Whaltze/SCARA/SCARA_UI/trajectory/patterns/爱心.png

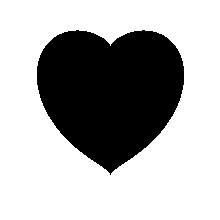
SCARA_UI/trajectory/patterns/爱心.png
