Whaltze/SCARA/(list of files, drawings)

Other design files:
PCB/Project Backups/新工程 [20260615, 14-53-20].pdsprj
PCB/Project Backups/新工程 [20260615, 15-15-52].pdsprj
PCB/Project Backups/新工程 [20260615, 15-15-53].pdsprj
PCB/Project Backups/新工程 [20260615, 15-25-33].pdsprj
PCB/Project Backups/新工程 [20260615, 15-25-38].pdsprj
PCB/Project Backups/新工程 [20260615, 15-33-31].pdsprj
PCB/Project Backups/新工程 [20260615, 16-06-37].pdsprj
PCB/Project Backups/新工程 [20260615, 16-11-07].pdsprj
PCB/Project Backups/新工程 [20260615, 16-44-57].pdsprj
PCB/Project Backups/新工程 [20260615, 17-07-40].pdsprj
PCB/新工程.pdsprj
