Whaltze/SCARA/SCARA_F103/UserApp/app_config.h

#ifndef APP_CONFIG_H
#define APP_CONFIG_H

/* 固件集中调参文件。
 * 机械尺寸、10kHz 控制周期、速度/加速度、串口缓冲、回零和 Flash 参数都优先在这里调整。
 * 修改后必须重新编译并重新烧录；同时确认 UI 里的 PPR、零点和机构尺寸保持一致。
 */

#include <stdint.h>

/* Firmware identity shown by VERSION. */
#define APP_FW_NAME "SCARA_F103"
#define APP_FW_VERSION "0.29.12-grbl-scara"

/* Current controller drives two stepper axes. */
#define APP_AXIS_COUNT 2u

/* Stepper driver ENA pins. Most optocoupled drivers enable when ENA is low. */
#define APP_STEPPER_ENA_ACTIVE_LEVEL 0u
#define APP_STEPPER_ENABLE_ON_BOOT 1u
/* Common-anode wiring: PUL+/DIR+/ENA+ to +5V, MCU drives PUL-/DIR-/ENA-.
 * The optocoupler is active when the MCU pin sinks low.
 */
#define APP_STEPPER_PUL_ACTIVE_LEVEL 0u
#define APP_STEPPER_M1_DIR_POSITIVE_LEVEL 1u
#define APP_STEPPER_M2_DIR_POSITIVE_LEVEL 0u
/* DM556 requires PUL high/low >= 2.5us and DIR setup >= 6us.
 * TIM1/TIM4 generate the pulse width in one-pulse mode. Only the uncommon
 * direction transition still uses the DWT setup delay.
 */
#define APP_STEPPER_PULSE_HIGH_US 3u
#define APP_STEPPER_PULSE_LOW_US 3u
#define APP_STEPPER_DIR_SETUP_US 6u

/* PWM 脉冲定时器基准频率，当前 1MHz 表示 1us 计数精度。 */
#define APP_STEPPER_TIMER_HZ 1000000u
/* 实时插补/速度更新频率。10000Hz 表示每 100us 执行一次运动内核。 */
#define APP_CONTROL_HZ 10000u
#define APP_CONTROL_PERIOD_US (1000000u / APP_CONTROL_HZ)
#define APP_STEPPER_ISR_DELAY_BUDGET_US (APP_CONTROL_PERIOD_US / 2u)
#define APP_STEPPER_WORST_BLOCKING_DELAY_US \
    (APP_AXIS_COUNT * APP_STEPPER_DIR_SETUP_US)

#if APP_STEPPER_WORST_BLOCKING_DELAY_US > APP_STEPPER_ISR_DELAY_BUDGET_US
#error "Configured step pulse delays exceed half of the control ISR period"
#endif

/* Laser PWM is generated by TIM3_CH2 at 1 kHz with 0.1% duty resolution.
 * ACTIVE_HIGH=1 matches the verified laser behavior: low/off, high/on.
 * Do not change the polarity while the laser is powered. Verify it with the
 * laser power disconnected and measure PA7 relative to the laser power GND.
 */
#define APP_LASER_PWM_HZ 1000u
#define APP_LASER_PWM_PERIOD_COUNTS 1000u
#define APP_LASER_COMMISSIONED 1u
#define APP_LASER_PWM_ACTIVE_HIGH 1u
#if APP_LASER_PWM_ACTIVE_HIGH
#define APP_LASER_PWM_OFF_COMPARE 0u
#else
#define APP_LASER_PWM_OFF_COMPARE APP_LASER_PWM_PERIOD_COUNTS
#endif
#define APP_LASER_POWER_DEFAULT_PERMILLE 10u
#define APP_LASER_POWER_MIN_PERMILLE 1u
#define APP_LASER_POWER_MAX_PERMILLE 50u
#define APP_LASER_BOOT_LOCKOUT_MS 1000u
#define APP_LASER_RELAY_READY_MS 100u
#define APP_LASER_IDLE_DISARM_MS 250u
#define APP_LASER_ARM_TIMEOUT_MS 5000u

/* 继电器逻辑电平：1=高电平有效(IN 高=吸合/激光通电)，0=低电平有效(IN 低=吸合)。
 * 默认 1，与当前硬件(高电平有效模块)一致。
 * 【安全】fail-safe 要求"释放电平=激光断电"：固件在上电/复位/故障/空闲一律把继电器驱动到
 * 释放电平，且激光头务必接在继电器的 COM/NO(常开)——释放时 NO 断开=断电。切勿用 NC(常闭)。
 * 若更换为低电平有效的继电器板，必须把本值改为 0，并在"激光断电"下用万用表确认上电/复位
 * 瞬间 NO 为断开；同时注意 CubeMX 生成的 gpio.c 初始电平也需对应(见 Control.md 激光清单)。 */
#define APP_LASER_RELAY_ACTIVE_LEVEL 1u
/* 落笔前继电器预合(吃掉机械合闸延时)的默认时长 ms；M6 不带 P 参数时用此值。
 * 需 >= 继电器实际机械动作时间，默认复用 APP_LASER_RELAY_READY_MS。 */
#define APP_LASER_RELAY_PREP_MS APP_LASER_RELAY_READY_MS

/* 最低有效 PPS，低于该值按停止处理，防止很慢的抖动脉冲。 */
#define APP_MIN_EFFECTIVE_PPS 16
#define APP_INTERPOLATOR_MIN_PPS 1
/* Default single-axis speed limit. 6400 PPR requires more PPS at the same mm/s. */
#define APP_MAX_PPS_DEFAULT 10000
/* 单轴 PPS 硬上限，只用于保护，实际运行应留足余量。 */
#define APP_MAX_PPS_HARD 50000

/* 默认加速度，单位 pulses/s^2；调大响应快但更容易振动/丢步。 */
#define APP_ACCEL_DEFAULT 200



/* 加速度上限，防止上位机或命令传入过激参数。 */
#define APP_ACCEL_MAX 5000

/* Software pulse position range. Only used when MCU-side limits are enabled. */
#define APP_MOTOR_MIN_POS (-2000000000L)
#define APP_MOTOR_MAX_POS (2000000000L)
/* 1: host PC owns workspace/path limit checks.
 * 0: MCU also enforces motor pulse range / joint range checks.
 */
#define APP_HOST_OWNS_LIMIT_CHECKS 1u

/* 电机和传动参数，用于脉冲与关节角换算；必须和上位机、驱动器拨码一致。 */
/* Driver pulses per revolution. Keep firmware, UI and physical DIP switches at 6400. */
#define APP_PULSES_PER_REV_M1 6400L
#define APP_PULSES_PER_REV_M2 6400L
/* Gear reduction ratio from motor shaft to active arm. */
#define APP_REDUCER_RATIO_M1 1L
#define APP_REDUCER_RATIO_M2 1L
/* Positive/negative sign for each motor direction. Use 1 or -1. */
#define APP_MOTOR1_DIR_SIGN 1L
#define APP_MOTOR2_DIR_SIGN 1L
/* Joint zero offsets in mrad after homing / mechanical calibration. */
#define APP_MOTOR1_ZERO_MRAD 2251L
#define APP_MOTOR2_ZERO_MRAD 890L

/* 反向间隙补偿（open-loop backlash compensation），单位：电机脉冲。
 * 每次电机换向时先多发这么多脉冲吃掉关节/联轴器旷量，再走正常轨迹；
 * 补偿不改动运动学位置(position_pulse)，只多发脉冲给驱动器。
 * 默认 0 = 未标定不补偿（行为与改动前一致）。现场用 $160/$161 在线标定，
 * 也可改这里的默认值。换算：pulses ≈ 旷量角(deg) × PPR / 360（PPR=6400 → 每脉冲≈0.056°）。
 * 只能补偿电机侧旷量；被动臂远端关节旷量需机械处理。
 */
#define APP_BACKLASH_PULSES_M1 0L
#define APP_BACKLASH_PULSES_M2 0L
/* 补偿脉冲发送速率（吃旷量为空载，定速无斜坡即可）。建议整除 APP_CONTROL_HZ。
 * 若标定时补偿段异响/丢步，调低此值。 */
#define APP_BACKLASH_COMP_PPS 2000
/* 补偿量上限保护，防止误设过大导致换向长时间空走。 */
#define APP_BACKLASH_MAX_PULSES 400L

/* SCARA geometry in micrometers.
 * Must match the upper computer kinematic model.
 */
/* Distance between the two base motor axes. */
#define APP_SCARA_BASE_UM 150000L
/* Left and right active arm lengths. */
#define APP_SCARA_ACTIVE1_UM 160000L
#define APP_SCARA_ACTIVE2_UM 160000L
/* Left and right passive arm lengths. */
#define APP_SCARA_PASSIVE1_UM 200000L
#define APP_SCARA_PASSIVE2_UM 200000L
/* Joint angle soft ranges in milliradians. */
#define APP_SCARA_THETA1_MIN_MRAD (-3142L)
#define APP_SCARA_THETA1_MAX_MRAD 3142L
#define APP_SCARA_THETA2_MIN_MRAD 0L
#define APP_SCARA_THETA2_MAX_MRAD 6283L
/* Elbow branch selection for inverse kinematics. Usually keep paired with UI. */
#define APP_SCARA_IK_LEFT_ELBOW_SIGN 1
#define APP_SCARA_IK_RIGHT_ELBOW_SIGN (-1)

/* Communication watchdog default.
 * 0 disables watchdog on boot; can be enabled later by command.
 */
#define APP_COMM_WATCHDOG_DEFAULT_MS 0u

/* Serial buffers and protocol sizing. */
/* Raw UART RX DMA ring buffer size in bytes. */
#define APP_SERIAL_RX_DMA_SIZE 256u
/* Grbl-style parsed-byte ring used by character-counting host streaming. */
#define APP_SERIAL_RX_RING_SIZE 256u
/* Max accepted single ASCII command line length. */
#define APP_SERIAL_LINE_SIZE 96u
/* TX staging buffer size for one formatted response. */
#define APP_SERIAL_TX_SIZE 512u
/* Realtime characters bypass the normal line queue. */
#define APP_SERIAL_REALTIME_QUEUE_DEPTH 8u
/* Number of pending TX messages that can wait in queue. */
#define APP_SERIAL_TX_QUEUE_DEPTH 8u
/* UART baudrate. Must match the upper computer. */
#define APP_SERIAL_BAUDRATE 115200u

/* Homing switch and homing process parameters. */
/* 0 means switch active-low, 1 means active-high. */
#define APP_HOME_SWITCH_ACTIVE_LEVEL 0u
/* Search direction for each homing axis. Use 1 or -1. 
// 左侧红色主动臂 Axis1：从 90° 竖直回零时应向左找水平限位，即角度增大到 180°。
*/

// 建议增加一个回零专用加速度，例如：
#define APP_HOME_ACCEL_PPS_S 3000

#define APP_HOME_AXIS1_DIR (1)
// 右侧蓝色主动臂 Axis2：若 HOME2 安装在右水平位置，则从 90° 竖直向右找 0°，角度减小。
#define APP_HOME_AXIS2_DIR (-1)
/* Homing search speed in pulses per second. */
#define APP_HOME_SEARCH_PPS 200
/* Pull-off distance after switch trigger, in pulses. */
#define APP_HOME_BACKOFF_PULSE 200L
/* Debounce time that the switch must stay active. */
#define APP_HOME_DEBOUNCE_MS 20u
/* Maximum allowed homing duration before timeout.   超时 时间*/
#define APP_HOME_TIMEOUT_MS 300000u
/* Joint angle references used by homing, in milliradians. 
两个臂的回零 轴1向着左边，轴2向着右边
左红臂水平回零点：向左水平 = 180° ≈ 3142 mrad。

mrad = deg × π / 180 × 1000
*/
// HORIZONTAL_MRAD：理论水平角度，仅用于仿真或参考
// SWITCH_MRAD：真实开关触发角度，用于实机回零标定
// VERTICAL_MRAD：回零后要回到的 90° 位置
#define APP_HOME_AXIS1_SWITCH_MRAD 3316L    /* 示例：左臂触发点约 190° */
#define APP_HOME_AXIS2_SWITCH_MRAD (-175L)   /* 示例：右臂触发点约 -5° */

#define APP_HOME_AXIS1_HORIZONTAL_MRAD 3142L
#define APP_HOME_AXIS2_HORIZONTAL_MRAD 0L
#define APP_HOME_AXIS1_VERTICAL_MRAD 1571L
#define APP_HOME_AXIS2_VERTICAL_MRAD 1571L

/* G-code stream planner parameters. */
/* Number of queued motion blocks kept by MCU. */
#define APP_GCODE_PLANNER_BLOCKS 48u
/* Timed DDA segments prefetched below the planner for queue-to-queue handoff. */
#define APP_STEPPER_TIMED_SEGMENTS 16u
#define APP_GRBL_SEGMENT_MS 5u
#define APP_GRBL_ACCEL_MM_S2 100.0f
#define APP_GRBL_MAX_ACCEL_MM_S2 1000.0f
#define APP_GRBL_JUNCTION_DEVIATION_MM 0.02f
#define APP_GRBL_ARC_TOLERANCE_MM 0.05f
#define APP_GRBL_MAX_FEED_MM_MIN 6000.0f
#define APP_GRBL_RAPID_MM_MIN 3000.0f
/* Wait time for the first block so a second block can arrive for blending. */
#define APP_GCODE_BLEND_MIN_BLOCKS 12u
#define APP_GCODE_BLEND_START_DELAY_MS 40u
/* Keep the final unknown-successor block in the planner while enough step
 * segments remain queued. This gives streamed short blocks time to arrive and
 * preserves their junction context instead of repeatedly planning from rest. */
#define APP_GCODE_TAIL_HOLDBACK_SEGMENTS 8u
/* Automatic status push period while streaming. */
#define APP_GCODE_STATUS_PERIOD_MS 200u
/* Default feed rate for G1 if host does not send F, in mm/min. */
#define APP_GCODE_DEFAULT_FEED_MM_MIN 300L
/* Retained persisted parameter for existing flash layouts. */
#define APP_MOVL_SEGMENT_UM 2000L

/* When a move settles (planner empty, stepper idle), the parser position is
 * re-anchored to the stepped pulses only if it diverges from the commanded
 * endpoint by more than this many pulses. Cleanly completed moves match exactly
 * (divergence 0) and keep their commanded coordinate; interrupted/fault-stopped
 * moves are re-anchored to the true stopped position. */
#define APP_POSITION_RESYNC_PULSE_TOL 2

/* Flash parameter page definition. */
/* Last flash page reserved for persisted AppParams. */
#define APP_PARAM_FLASH_ADDR 0x0800F800u
/* Flash page size for STM32F103C8/CB family. */
#define APP_PARAM_FLASH_PAGE_SIZE 1024u
/* Magic tag used to validate saved parameter blocks. */
#define APP_PARAM_FLASH_MAGIC 0x53434152u
/* Increment when default parameter layout/meaning changes. */
#define APP_PARAM_FLASH_VERSION 7u

#endif
