Whaltze/SCARA/SCARA_F103/Core/Inc/main.h

#define M1_DIR_Pin GPIO_PIN_12
#define M1_DIR_GPIO_Port GPIOB
#define M1_ENA_Pin GPIO_PIN_13
#define M1_ENA_GPIO_Port GPIOB
#define M1_PUL_Pin GPIO_PIN_8
#define M1_PUL_GPIO_Port GPIOA
#define LASER_RELAY_Pin GPIO_PIN_2
#define LASER_RELAY_GPIO_Port GPIOA
#define LASER_PWM_Pin GPIO_PIN_7
#define LASER_PWM_GPIO_Port GPIOA
#define USART1_TX_Pin GPIO_PIN_9
#define USART1_TX_GPIO_Port GPIOA
#define USART1_RX_Pin GPIO_PIN_10
#define USART1_RX_GPIO_Port GPIOA
#define HOME1_Pin GPIO_PIN_0
#define HOME1_GPIO_Port GPIOB
#define HOME2_Pin GPIO_PIN_1
#define HOME2_GPIO_Port GPIOB
#define M2_PUL_Pin GPIO_PIN_6
#define M2_PUL_GPIO_Port GPIOB
#define M2_DIR_Pin GPIO_PIN_7
#define M2_DIR_GPIO_Port GPIOB
#define M2_ENA_Pin GPIO_PIN_8
#define M2_ENA_GPIO_Port GPIOB
