Whaltze/SCARA/(commit log)

2026-06-10 与实机进行联调
    [ui_binary_car1_endpoint_latest.csv, ui_binary_car2_endpoint_latest.csv, ui_binary_line_endpoint_20mms.csv, ui_binary_line_endpoint_2mms.csv, ui_binary_line_endpoint_5mms.csv]
2026-06-10 解决了毫弧度提前取整的问题
2026-06-10 极大修复重定位误差
2026-06-14 6.14测试版本
2026-06-14 Revert "修改"
    This reverts commit f3114b572f21eee05deb2ee31030e9febe5248c2.
    [app_config.h, gcode_stream.c, motion_planner.c]
2026-06-15 完善激光功能
2026-06-15 视觉功能完善
    1
2026-06-15 加入电气接线图
    [新工程 [20260615, 14-53-20].pdsprj, 新工程 [20260615, 15-15-52].pdsprj, 新工程 [20260615, 15-15-53].pdsprj, 新工程 [20260615, 15-25-33].pdsprj, 新工程 [20260615, 15-25-38].pdsprj, 新工程 [20260615, 15-33-31].pdsprj, 新工程 [20260615, 16-06-37].pdsprj, 新工程 [20260615, 16-11-07].pdsprj]
2026-06-15 视觉bug更新
    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
2026-06-15 审查视觉bug
2026-06-15 修复点动功能
